MBed0/mb-fixed-wing/README.md

<table>
  <tr>
    <td>
      <a href="MB_FlyingWing_Assembly_Guide.pdf" target="_blank">
        
      </a>
    </td>
  </tr>
</table>
