MBed0/mb-fixed-wing/Top_Hatch.3mf

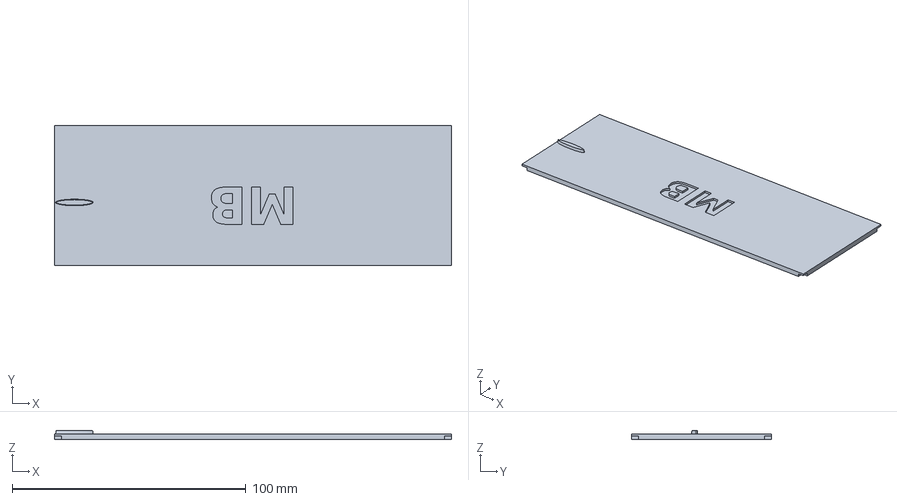
[picture p1: CAD file, 2026-08-27]
Top_Hatch.3mf
170.0 x 60.0 x 3.76 mm
