MBed0/mb-fixed-wing/Wing_1_Kok.3mf

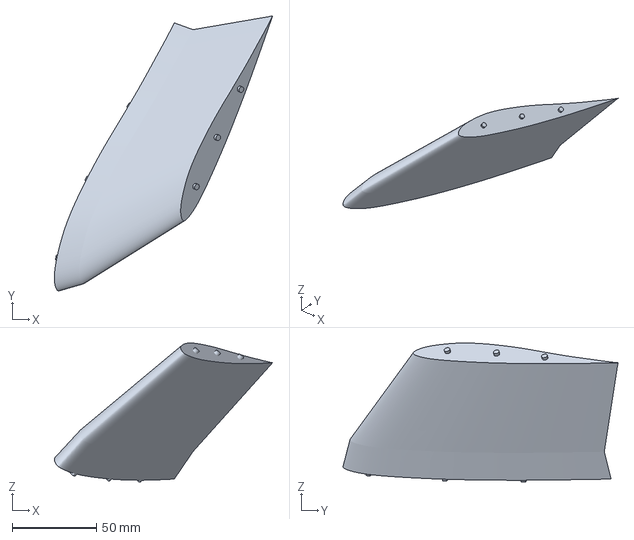
[picture p2: CAD file, 2026-08-27]
Wing_1_Kok.3mf
129.4 x 163.0 x 82.4 mm
