MBed0/mb-fixed-wing/Fuselage_Arka.3mf

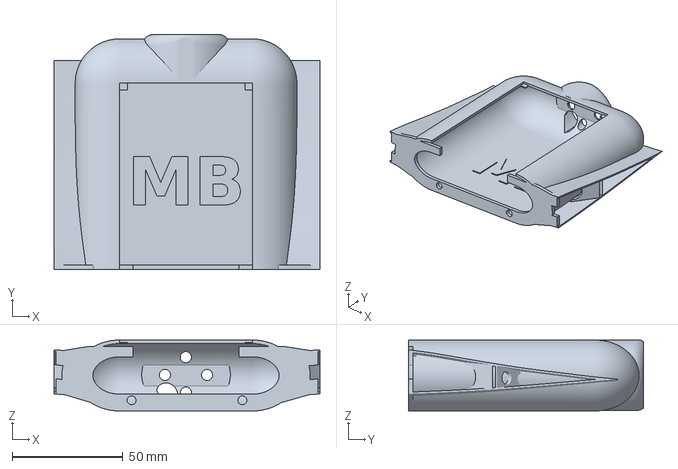
[picture p3: CAD file, 2026-08-27]
Fuselage_Arka.3mf
120.0 x 106.0 x 32.0 mm
