MBed0/mb-fixed-wing/Wing_2_Kok.3mf

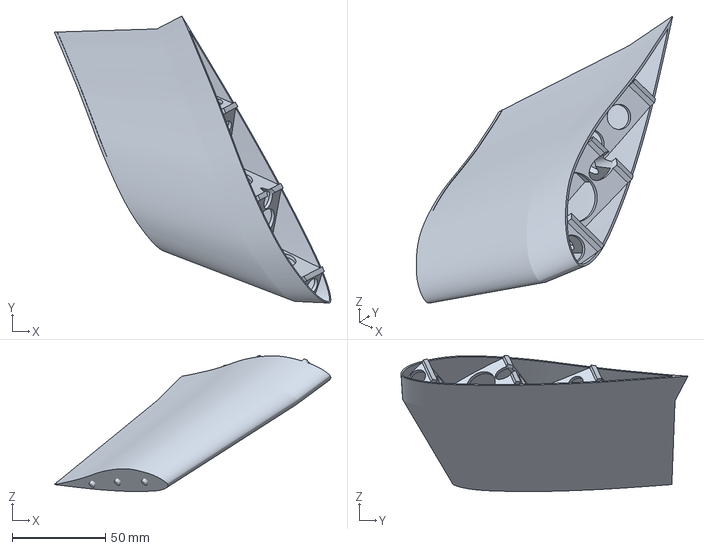
[picture p4: CAD file, 2026-08-27]
Wing_2_Kok.3mf
148.6 x 154.2 x 73.1 mm
