MBed0/mb-fixed-wing/Tip2.3mf

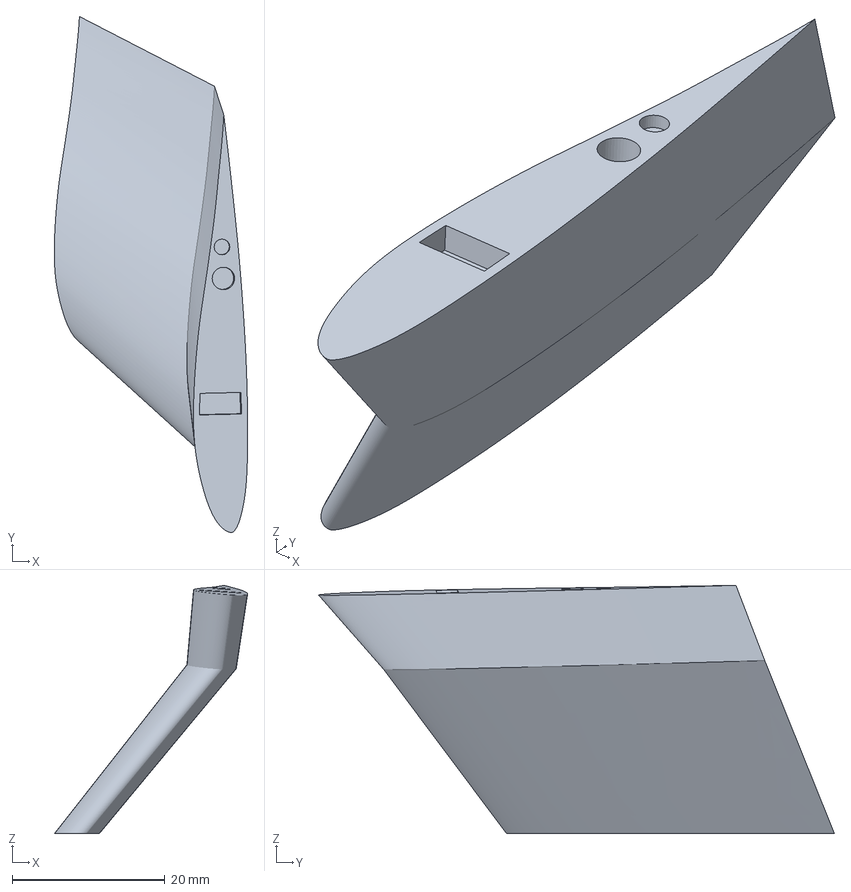
[picture p5: CAD file, 2026-08-27]
Tip2.3mf
25.4 x 67.7 x 32.6 mm
