MBed0/mb-fixed-wing/Elevon.3mf

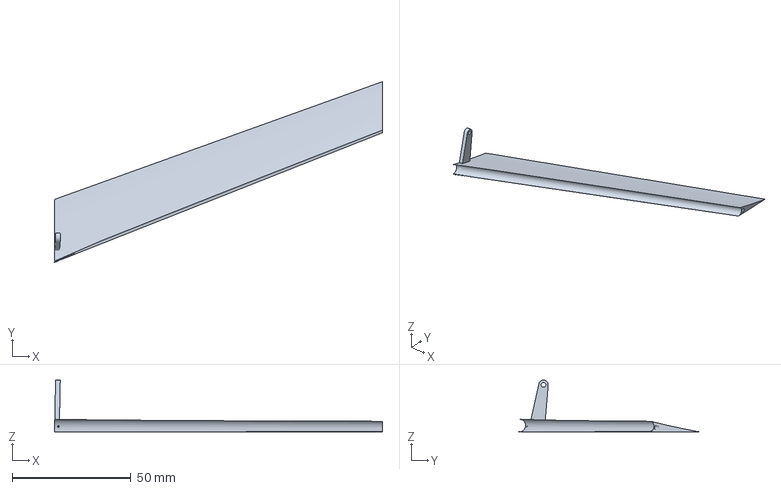
[picture p6: CAD file, 2026-08-27]
Elevon.3mf
138.2 x 76.1 x 21.8 mm
