MBed0/mb-fixed-wing/Wing_2_Uc.3mf

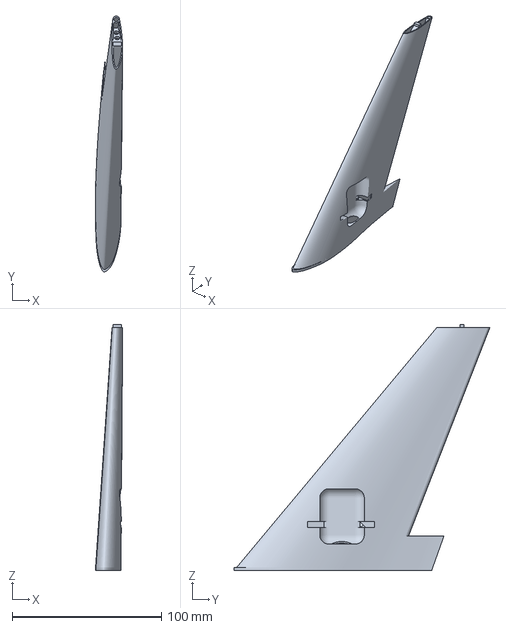
[picture p7: CAD file, 2026-08-27]
Wing_2_Uc.3mf
18.3 x 171.6 x 165.0 mm
