MBed0/mb-fixed-wing/Fuselage_Burun.3mf

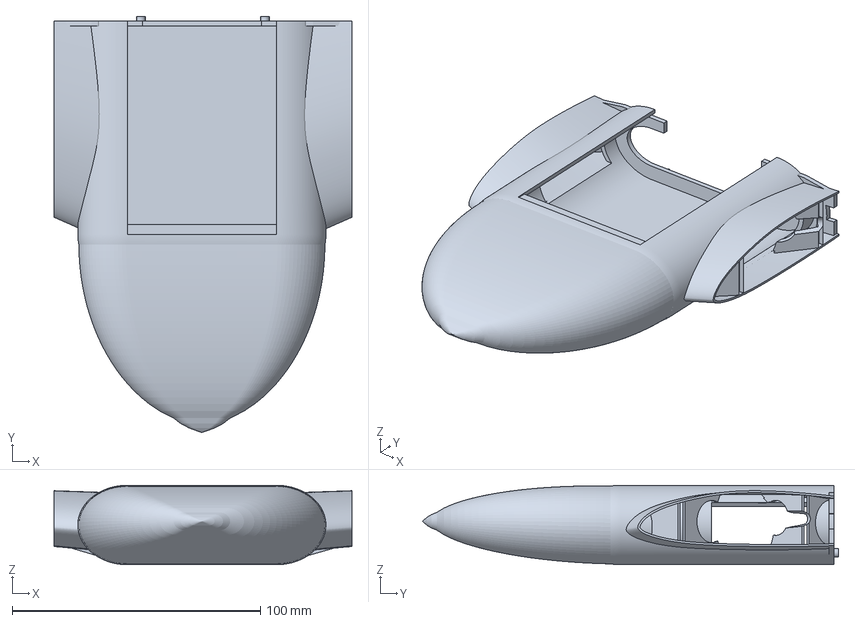
[picture p8: CAD file, 2026-08-27]
Fuselage_Burun.3mf
120.0 x 167.6 x 32.0 mm
