MBed0/mb-fixed-wing/(list of files, cad)

Other CAD files:
Elevon2.3mf
Wing_1_Uc.3mf
Tip.3mf
